ElektronikaDonBosco/VASCAR/Imagenes/Arduino Bloques.png

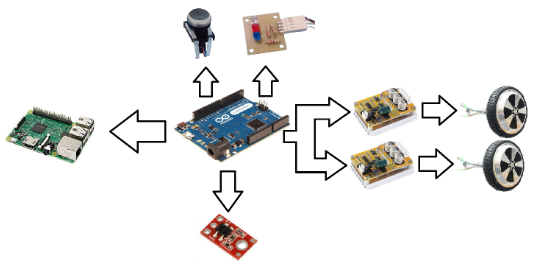
Imagenes/Arduino Bloques.png
