ElektronikaDonBosco/VASCAR/(list of files, drawings)

Other design files:
Esquema Eléctrico/Carro.pdsprj
